ChanghyeonKim93/f446_drone_shield_ros/mbed_code/readme.txt

Substitute TARGET_STM - TARGET_STM32F446xE - TARGET_NUCLEO_F446RE - 'PeripheralPins.c' to the provided 'PeripheralPins.c'
It is to use the PWM 4,5,6,7 (TIM8, PA6,PA7,PA8,PA9 pins). Note that PA6,PA7,PA8,PA9 pins are originally mapped to TIM3.
