ChanghyeonKim93/f446_drone_shield_ros/ros_code/include/union_struct.h

#ifndef _UNION_STRUCT_H_
#define _UNION_STRUCT_H_
#include <iostream>

// Unions
typedef union SHORT_UNION_{
    int16_t short_;
    unsigned char  bytes_[2];
} SHORT_UNION;

typedef union USHORT_UNION_{
    uint16_t ushort_;
    unsigned char  bytes_[2];
} USHORT_UNION;

typedef union INT_UNION_{
    int32_t int_;
    unsigned char bytes_[4];
} INT_UNION;

typedef union UINT_UNION_{
    uint32_t uint_;
    unsigned char bytes_[4];
} UINT_UNION;

typedef union UINT64_UNION_{
    uint64_t uint64_;
    unsigned char bytes_[8];
} UINT64_UNION;

typedef union FLOAT_UNION_{
    float float_;
    unsigned char bytes_[4];   
} FLOAT_UNION;

typedef union DOUBLE_UNION_{
    double double_;
    unsigned char bytes_[8];
} DOUBLE_UNION;

#endif
