ChanghyeonKim93/f446_drone_shield_ros/ros_code/src/node_serial_comm.cpp

#include <iostream>
#include <ros/ros.h>
#include "serial_comm_ros.h"

int main(int argc, char **argv) {
    ros::init(argc, argv, "serial_node");
    ros::NodeHandle nh("~");

    ROS_INFO_STREAM("serial_node - starts.");
	
	try{
		if(ros::ok()) {
			std::shared_ptr<SerialCommROS> serial_ros;
			serial_ros = std::make_shared<SerialCommROS>(nh);
		}
		else{
			throw std::runtime_error("ros not ok");
		}
	}
	catch (std::exception& e){
        ROS_ERROR(e.what());
	}

    ROS_INFO_STREAM("serial_node - terminated.");
	return 0;
}
