ChanghyeonKim93/f446_drone_shield_ros/(commit log)

2023-01-12 copied from the original repo. not working now.
    [crc16.cpp, main.cpp, serial_comm_ros.cpp, serial_comm_ros.h, serial_communicator.cpp, serial_communicator.h, test_publisher.cpp]
2023-01-12 icm42605 (arduino i2c version) is uploaded.
2023-01-18 spi communication init
2023-01-18 spi ok
2023-01-19 sensor data ok.
2023-03-12 schematic images are uploaded.
2023-03-27 update: timer.h/.cpp and union struct
2023-04-10 Modify print sentences
2023-05-11 update acc, gyro range
2023-05-20 change the error (mbed code)
    [main.cpp]
